Zinxiee/Torque_of_the_Town/README.md

# Torque_of_the_Town
Mechatronics Group 1 Coursework 25WSC912

## Video Demos:
### Torquey - Single-Disc collection Demo:

Torquey - Single-Disc collection Demo (https://www.youtube.com/watch?v=3hX0Q1lNYFE)

### Torquey - Multi-Disc collection Demo:

Torquey - Multi-Disc collection Demo (https://www.youtube.com/watch?v=oQwFLpYt4kk)

## MAIN FILES:
ESP32S3 Code is located in ESP32S3_motor_control.ino  
XIAO ESP32S3 Sense Camera code is located in XIAO_CAM_V2.ino  
(apologies for the state of the repository)  

2D_similarity_transform_maths.py is for working out 2D similarity transform constants and shouldn't need to be edited or used.  

XIAO_CAM_V2 (the newer version with multi blob detection) is uploaded to the camera and is responsible for starting a wifi network called RobotVision, with password "TorqueOfTheTown". To see the output stream of the camera, connect to the wifi network on any device and search for http://192.168.4.1 in your browser. XIAO_CAM is responsible for image thresholding, cropping, and blob detection for the white disc. If enough white pixels are present, it finds the average x and y locations of those pixels and draws a crosshair. The centre of this crosshair (the average) is (hopefully) the centre of the disc. This central location is what is transmitted (over wire) to the ESP32S3 for use in detect_disc_location_from_world_frame.  

ESP32S3_motor_control.ino is to be uploaded to the main ESP32S3 for control of the motors, on startup it sets the home location by moving to the limit switches and then enters the state machine (seen in the code). It is responsible for detecting the disc location from the world frame (drawn on the board with a pink cross directly below the 2nd Igus motor) as well as the inverse kinematics.  

detect_disc_location_from_world_frame.ino is an old file and is replaced by the calculateDiscLocation class inside ESP32S3_motor_control.ino. It is using the 2D similarity constants and the pixel locations of the corners of the red pickup boundry to work out where the disc is. It expects a pixel location for the centre of the disc from the camera (sent via the XIAO_CAM code). The output of this is a measurement in mm from the world frame as to the whereabouts of the white disc.
