Zinxiee/Torque_of_the_Town/(commit log)

2026-02-25 added boundary boxes to cam and switched x,y axis
2026-02-26 Fix camera serial pin configuration
    [detect_disc_location_from_world_frame.ino]
2026-03-24 Update camera coordinates for transformation calculations
2026-03-28 Update steps per degree calculations for motors
2026-04-01 update inverse kinematics
2026-04-01 Update motor scaling parameters for inverse kinematics
2026-04-01 Add motor_control_example.ino file
2026-04-01 Update serial print message for lift up point
2026-04-02 Update Motor_Control_Kyr_Attempt
2026-04-05 fixed 5/6 major bugs in STATE MACHINE
    [ESP32S3_motor_control.ino]
2026-04-05 Update README with code location details
    Added information about ESP32S3 and XIAO ESP32S3 Sense Camera code locations.
2026-04-11 Increase tolerance for float comparison to 3mm
    [ESP32S3_motor_control.ino]
2026-04-11 Add comment for camera section in motor control
2026-04-11 Improve data handling in handleLocatingDisc function
    Refactor handleLocatingDisc to read and discard all incoming data from CameraSerial before processing the last line.
2026-04-13 Modify camera coordinates in 2D similarity transform
    Updated camera coordinates for pixel values.
2026-04-14 Handle Failed joint limits by transitioning to locating state
    [ESP32S3_motor_control.ino]
2026-07-29 Add YouTube demo links to README
    Added demo video links for Torquey project in README.
2026-07-29 Embed YouTube video for Single-Disc collection demo
    Added an embedded YouTube video for the Torquey - Single-Disc collection demo.
